irudoy/openmfd/firmware/TouchGFX/assets/images/graph-bg-6-11.png

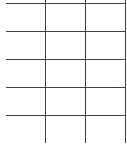
firmware/TouchGFX/assets/images/graph-bg-6-11.png
