irudoy/openmfd/hardware/dev-board/dev-board.kicad_pcb

## KiCad design hardware/dev-board/dev-board.kicad_pcb (2024-07-24)

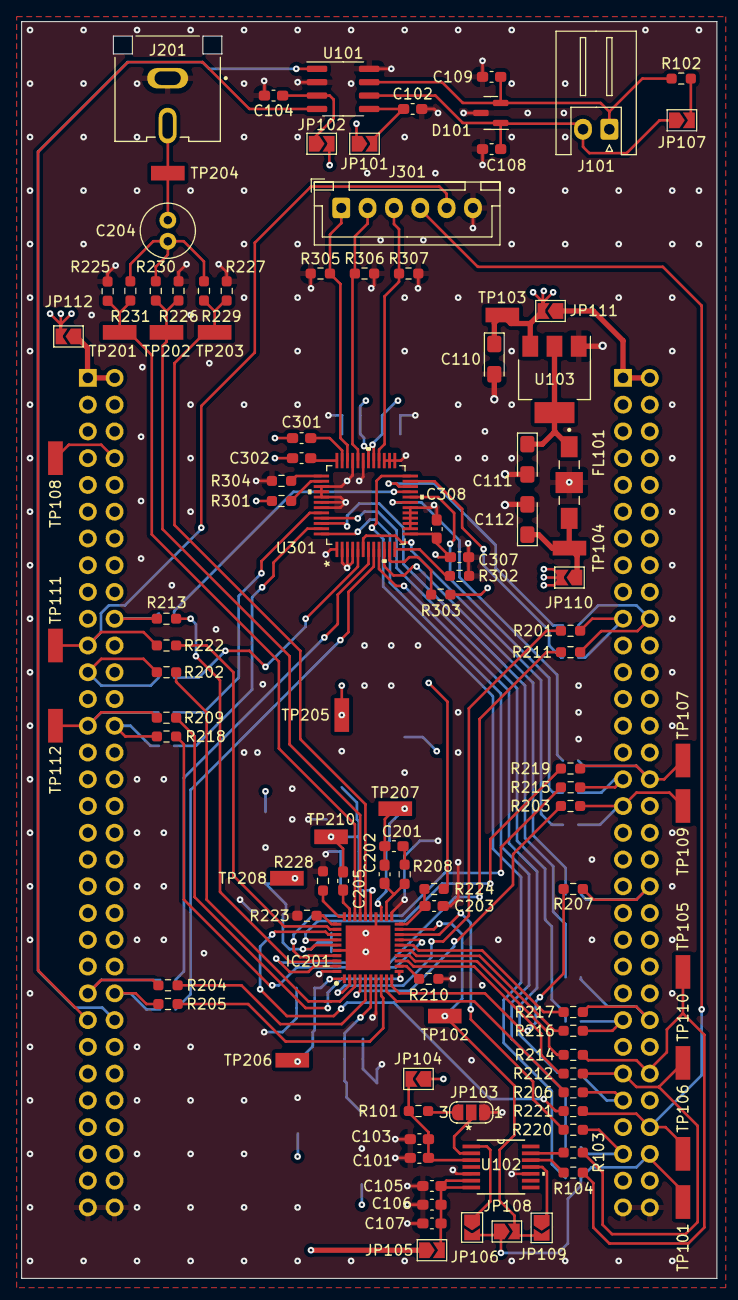
[picture p2: board dev-board.kicad_pcb from above]

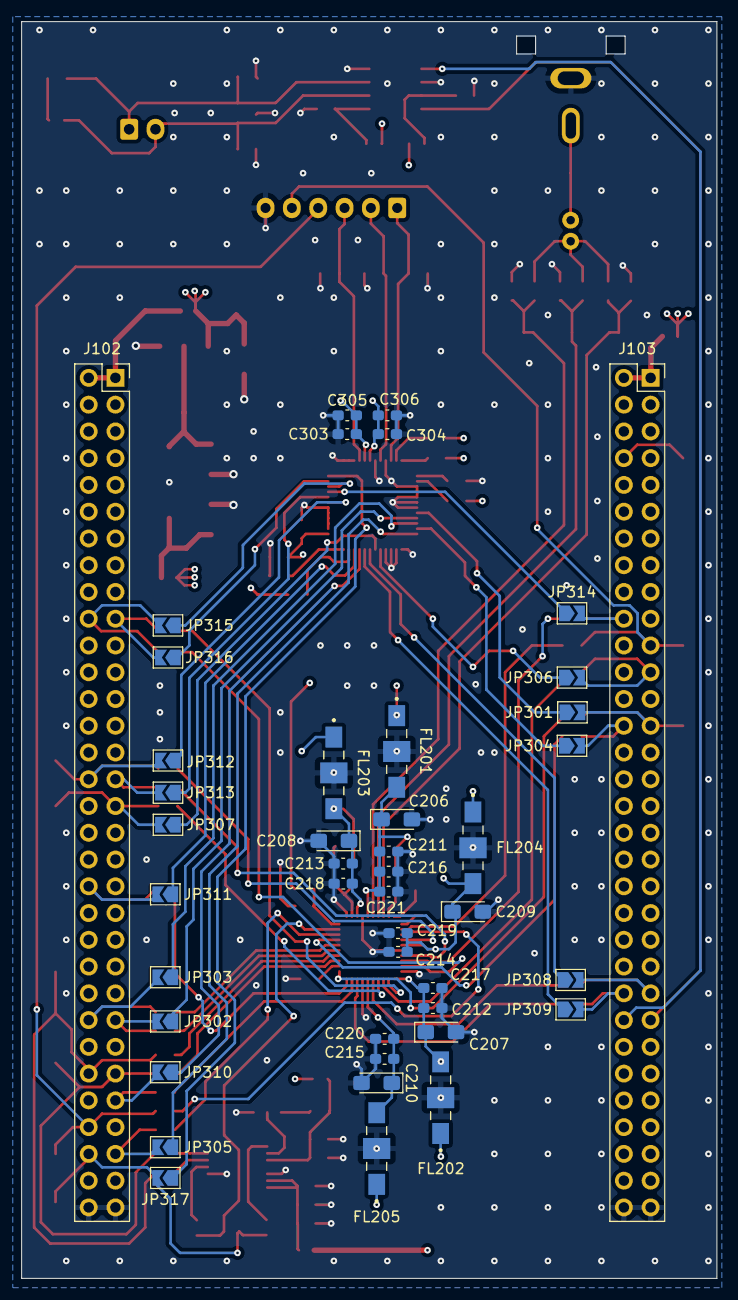
[picture p3: board dev-board.kicad_pcb from below]

Board: 4 copper layers, 66.0 x 119.3 mm, 150 parts (44 on the bottom side), 109 nets.

Parts:
C101, C102, C104, C105, C106, C203, C211, C212, C213, C214, C215: 100n; C_0603_1608Metric_Pad1.08x0.95mm_HandSolder
C103, C107, C221: 1u; C_0603_1608Metric_Pad1.08x0.95mm_HandSolder
C108, C109: 47p; C_0603_1608Metric_Pad1.08x0.95mm_HandSolder
C110: 10u; CP_EIA-3216-18_Kemet-A_Pad1.58x1.35mm_HandSolder
C111: 22u; CP_EIA-3216-18_Kemet-A_Pad1.58x1.35mm_HandSolder
C112, C206, C207, C208, C209, C210: 33u; CP_EIA-3216-18_Kemet-A_Pad1.58x1.35mm_HandSolder
C201: 150n; C_0603_1608Metric_Pad1.08x0.95mm_HandSolder
C202: 12n; C_0603_1608Metric_Pad1.08x0.95mm_HandSolder
C204: 220uf; C_Radial_D5.0mm_H11.0mm_P2.00mm
C205: 2n2; C_0603_1608Metric_Pad1.08x0.95mm_HandSolder
C216, C217, C218, C219, C220: 10n; C_0603_1608Metric_Pad1.08x0.95mm_HandSolder
C301, C302, C303, C304, C307: 100nf; C_0603_1608Metric_Pad1.08x0.95mm_HandSolder
C305, C306, C308: 10nf; C_0603_1608Metric_Pad1.08x0.95mm_HandSolder
D101: ESDCAN24-2BLY; SOT-23
FL101, FL201, FL202, FL203, FL204, FL205: Filter_EMI_LCL; FIL_NFE61PT472C1H9L
IC201: ADV7393BCPZ; QFN50P600X600X80-41N
J101: Conn_01x02_Pin; JST_XH_S2B-XH-A_1x02_P2.50mm_Horizontal
J102: DISC1-P1; PinSocket_2x32_P2.54mm_Vertical
J103: DISC1-P2; PinSocket_2x32_P2.54mm_Vertical
J201: CVBS; CUI_RCJ-044
J301: Connector RGB; JST_XH_B6B-XH-A_1x06_P2.50mm_Vertical
JP101, JP102, JP104, JP105, JP106, JP107, JP108, JP109, JP110, JP111, JP112, JP301, JP302, JP303, JP304, JP305, JP306, JP307, JP308, JP309, JP310, JP311, JP312, JP313, JP314, JP315, JP316, JP317: SolderJumper_2_Open; SolderJumper-2_P1.3mm_Open_TrianglePad1.0x1.5mm
JP103: SolderJumper_3_Open; SolderJumper-3_P1.3mm_Open_RoundedPad1.0x1.5mm_NumberLabels
R101, R223, R229, R230, R231: 0Ω; R_0603_1608Metric_Pad0.98x0.95mm_HandSolder
R102: 120; R_0603_1608Metric_Pad0.98x0.95mm_HandSolder
R103, R104, R201, R202, R203, R204, R205, R206, R207, R209, R210, R211, R212, R213, R214, R215, R216, R217, R218, R219, R220, R221, R222: 0; R_0603_1608Metric_Pad0.98x0.95mm_HandSolder
R208: 170 (169); R_0603_1608Metric_Pad0.98x0.95mm_HandSolder
R224: 10K; R_0603_1608Metric_Pad0.98x0.95mm_HandSolder
R225, R226, R227, R305, R306, R307: 75; R_0603_1608Metric_Pad0.98x0.95mm_HandSolder
R228: 510 1%; R_0603_1608Metric_Pad0.98x0.95mm_HandSolder
R301, R303: 4K7; R_0603_1608Metric_Pad0.98x0.95mm_HandSolder
R302: 1K; R_0603_1608Metric_Pad0.98x0.95mm_HandSolder
R304: 560; R_0603_1608Metric_Pad0.98x0.95mm_HandSolder
TP101, TP102, TP103, TP104, TP105, TP106, TP107, TP108, TP109, TP110, TP111, TP112, TP201, TP202, TP203, TP204, TP205, TP206, TP207, TP208, TP210: TestPoint_Flag; KEYSTONE_5015
U101: MCP2562-E-SN; SOIC-8_3.9x4.9mm_P1.27mm
U102: CDCE913PW; PW14
U103: AMS1117-1.8; SOT-223-3_TabPin2
U301: ADV7125KSTZ140

Connections:
+1V8: FL203.1, FL204.1, FL205.1, JP104.1 (A), JP110.2 (B)
+1V8_I: C101.1, C103.1, JP104.2 (B), R101.1, U102.3 (VDD)
+3V3: FL201.1, FL202.1, JP101.1 (A), JP105.1 (A), JP112.2 (B), R224.2, TP205.1
+3V3_C: C102.1, JP101.2 (B), U101.5 (Vio)
+3V3_I: C105.1, C106.1, C107.1, JP105.2 (B), U102.6 (VDDOUT), U102.7 (VDDOUT)
+3V3_IN: J103.1 (3V3), J103.2 (3V3), JP112.1 (A)
+5V: C110.1, C301.2, C302.2, C303.2, C304.2, C305.2, C306.2, C307.2, C308.2, JP102.2 (B), JP111.2 (B), R301.2, R303.2, TP103.1, U103.3 (VI), U301.13 (VAA), U301.29 (VAA), U301.30 (VAA)
+5V_C: C104.1, JP102.1 (A), U101.3 (VDD)
+5V_IN: J102.1 (5V), J102.2 (5V), JP111.1 (A)
/CANH: C109.1, D101.2 (K), J101.1, R102.1, U101.7 (CANH)
/CANL: C108.2, D101.1 (K), J101.2, JP107.1 (A), U101.6 (CANL)
ADV7_B3: JP312.1 (A), U301.19 (B3)
ADV7_B4: JP313.1 (A), U301.20 (B4)
ADV7_B5: JP314.1 (A), U301.21 (B5)
ADV7_B6: JP315.1 (A), U301.22 (B6)
ADV7_B7: JP316.1 (A), U301.23 (B7)
ADV7_CLK: JP317.1 (A), U301.24 (CLOCK)
ADV7_G2: JP306.1 (A), U301.5 (G2)
ADV7_G3: JP307.1 (A), U301.6 (G3)
ADV7_G4: JP308.1 (A), U301.7 (G4)
ADV7_G5: JP309.1 (A), U301.8 (G5)
ADV7_G6: JP310.1 (A), U301.9 (G6)
ADV7_G7: JP311.1 (A), U301.10 (G7)
ADV7_IOB: J301.3, R307.1, U301.28 (IOB)
ADV7_IOG: J301.2, R306.1, U301.32 (IOG)
ADV7_IOR: J301.1, R305.1, U301.34 (IOR)
ADV7_R3: JP301.1 (A), U301.44 (R3)
ADV7_R4: JP302.1 (A), U301.45 (R4)
ADV7_R5: JP303.1 (A), U301.46 (R5)
ADV7_R6: JP304.1 (A), U301.47 (R6)
ADV7_R7: JP305.1 (A), U301.48 (R7)
ADV_CLKIN: IC201.19 (CLKIN), JP108.2 (B), JP109.2 (B), TP102.1
ADV_COMP: C205.2, IC201.29 (COMP)
ADV_RSET: IC201.30 (RSET), R228.2
AVDD_3V3: C205.1, C206.1, C211.1, C216.1, C221.1, FL201.3, IC201.25 (VAA), TP210.1
CAN_RX: J103.49 (PB12), U101.4 (RXD)
CAN_TX: J103.50 (PB13), U101.1 (TXD)
DAC_1: IC201.28 (DAC_1), R225.2, R231.2, TP201.1
DAC_2: IC201.27 (DAC_2), R226.2, R230.2, TP202.1
DAC_3: IC201.26 (DAC_3), R227.2, R229.2, TP203.1
DVDD_1V8_1: C210.1, C215.1, C220.1, FL205.3, IC201.6 (VDD_1)
DVDD_1V8_2: C209.1, C214.1, C219.1, FL204.3, IC201.35 (VDD_2), TP208.1
DVDD_IO_3V3: C207.1, C212.1, C217.1, FL202.3, IC201.1 (VDD_IO), TP206.1
EXT_LF: C202.2, IC201.22 (EXT_LF), R208.1
GND: C101.2, C102.2, C103.2, C104.2, C105.2, C106.2, C107.2, C108.1, C109.2, C110.2, C111.2, C112.2, C203.2, C206.2, C207.2, C208.2, C209.2, C210.2, C211.2, C212.2, C213.2, C214.2, C215.2, C216.2, C217.2, C218.2, C219.2, C220.2, C221.2, C303.1, C304.1, C305.1, C306.1, C307.1, C308.1, D101.3 (A), FL101.2, FL201.2, FL202.2, FL203.2, FL204.2, FL205.2, IC201.7 (DGND_1), IC201.21 (PGND), IC201.24 (AGND_1), IC201.36 (DGND_2), IC201.40 (GND_IO), IC201.41 (AGND_2), J102.63 (GND), J102.64 (GND), J103.63 (GND), J103.64 (GND), J201.2 (Ext), J301.6, JP103.1 (A), R210.1, R223.1, R225.1, R226.1, R227.1, R228.1, R302.2, R304.2, R305.2, R306.2, R307.2, U101.2 (VSS), U101.8 (STBY), U102.5 (GND), U102.10 (GND), U103.1 (GND), U301.1 (GND), U301.2 (GND), U301.3 (G0), U301.4 (G1), U301.14 (GND), U301.15 (GND), U301.16 (B0), U301.17 (B1), U301.18 (B2), U301.25 (GND), U301.26 (GND), U301.27 (IOB*), U301.31 (IOG*), U301.33 (IOR*), U301.39 (GND), U301.40 (GND), U301.41 (R0), U301.42 (R1), U301.43 (R2)
I2C_SCL: J102.54 (PA8), R104.1, R214.1, TP105.1
I2C_SDA: J102.53 (PC9), R103.1, R212.1, TP110.1
LTDC_B3: J102.32 (PG11), JP312.2 (B), R219.2, TP107.1
LTDC_B4: J102.31 (PG12), JP313.2 (B), R215.2
LTDC_B5: J103.20 (PA3), JP314.2 (B), R213.2
LTDC_B6: J102.20 (PB8), JP315.2 (B), R211.2
LTDC_B7: J102.19 (PB9), JP316.2 (B), R201.1
LTDC_CLK: J102.60 (PG7), JP106.2 (B), JP108.1 (A), JP317.2 (B), TP101.1
LTDC_DE: J103.8 (PF10), TP108.1
LTDC_G2: J103.23 (PA6), JP306.2 (B), R202.1
LTDC_G3: J102.33 (PG10), JP307.2 (B), R203.1, TP109.1
LTDC_G4: J103.47 (PB10), JP308.2 (B), R204.1
LTDC_G5: J103.48 (PB11), JP309.2 (B), R205.1
LTDC_G6: J102.55 (PC7), JP310.2 (B), R206.1
LTDC_G7: J102.40 (PD3), JP311.2 (B), R207.1
LTDC_HSYNC: J102.58 (PC6), J301.4, R221.2, TP106.1
LTDC_R3: J103.27 (PB0), JP301.2 (B), R209.1, TP112.1
LTDC_R4: J102.49 (PA11), JP302.2 (B), R216.1
LTDC_R5: J102.50 (PA12), JP303.2 (B), R217.1
LTDC_R6: J103.28 (PB1), JP304.2 (B), R218.1
LTDC_R7: J102.59 (PG6), JP305.2 (B), R220.1
LTDC_VSYNC: J103.21 (PA4), J301.5, R222.2, TP111.1
unnamed: C201.2, R208.2
unnamed: C204.1, R229.1, R230.1, R231.1
unnamed: IC201.12 (ALSB), R210.2
unnamed: IC201.34 (P0), R219.1
unnamed: IC201.37 (P1), R215.1
unnamed: IC201.38 (P2), R213.1
unnamed: IC201.39 (P3), R211.1
unnamed: IC201.2 (P4), R201.2
unnamed: IC201.3 (P5), R202.2
unnamed: IC201.4 (P6), R203.2
unnamed: IC201.5 (P7), R204.2
unnamed: IC201.8, R205.2
unnamed: IC201.9, R206.2
unnamed: IC201.10, R207.2
unnamed: IC201.11, R209.2
unnamed: IC201.15 (P12), R216.2
unnamed: IC201.16 (P13), R217.2
unnamed: IC201.17 (P14), R218.2
unnamed: IC201.18 (P15), R220.2
unnamed: IC201.14 (SCL), R214.2
unnamed: IC201.13 (SDA), R212.2
unnamed: IC201.33 (~HSYNC), R221.1
unnamed: C203.1, IC201.20 (~RESET), R224.1
unnamed: IC201.32 (~VSYNC), R222.1
unnamed: C204.2, J201.1 (In), TP204.1
unnamed: JP103.3 (B), R101.2
unnamed: JP103.2 (C), U102.2 (S0)
unnamed: JP106.1 (A), U102.1 (XIN/CLK)
unnamed: JP107.2 (B), R102.2
unnamed: JP109.1 (A), U102.11 (Y1)
unnamed: C112.1, FL101.3, JP110.1 (A), TP104.1
unnamed: R103.2, U102.13 (S1/SDA)
unnamed: R104.2, U102.12 (S2/SCL)
unnamed: C111.1, FL101.1, U103.2 (VO)
unnamed: R303.1, U301.11 (BLANK*)
unnamed: C301.1, U301.35 (COMP)
unnamed: R301.1, U301.38 (PSAVE*)
unnamed: R304.1, U301.37 (RSET)
unnamed: R302.1, U301.12 (SYNC*)
unnamed: C302.1, U301.36 (VREF)
PVDD_1V8: C201.1, C202.1, C208.1, C213.1, C218.1, FL203.3, IC201.23 (PVDD), TP207.1
SFL: IC201.31 (SFL), R223.2
