irudoy/openmfd/hardware/openmfd/dummy/openmfd.kicad_pcb

## KiCad design hardware/openmfd/dummy/openmfd.kicad_pcb (2024-05-24)

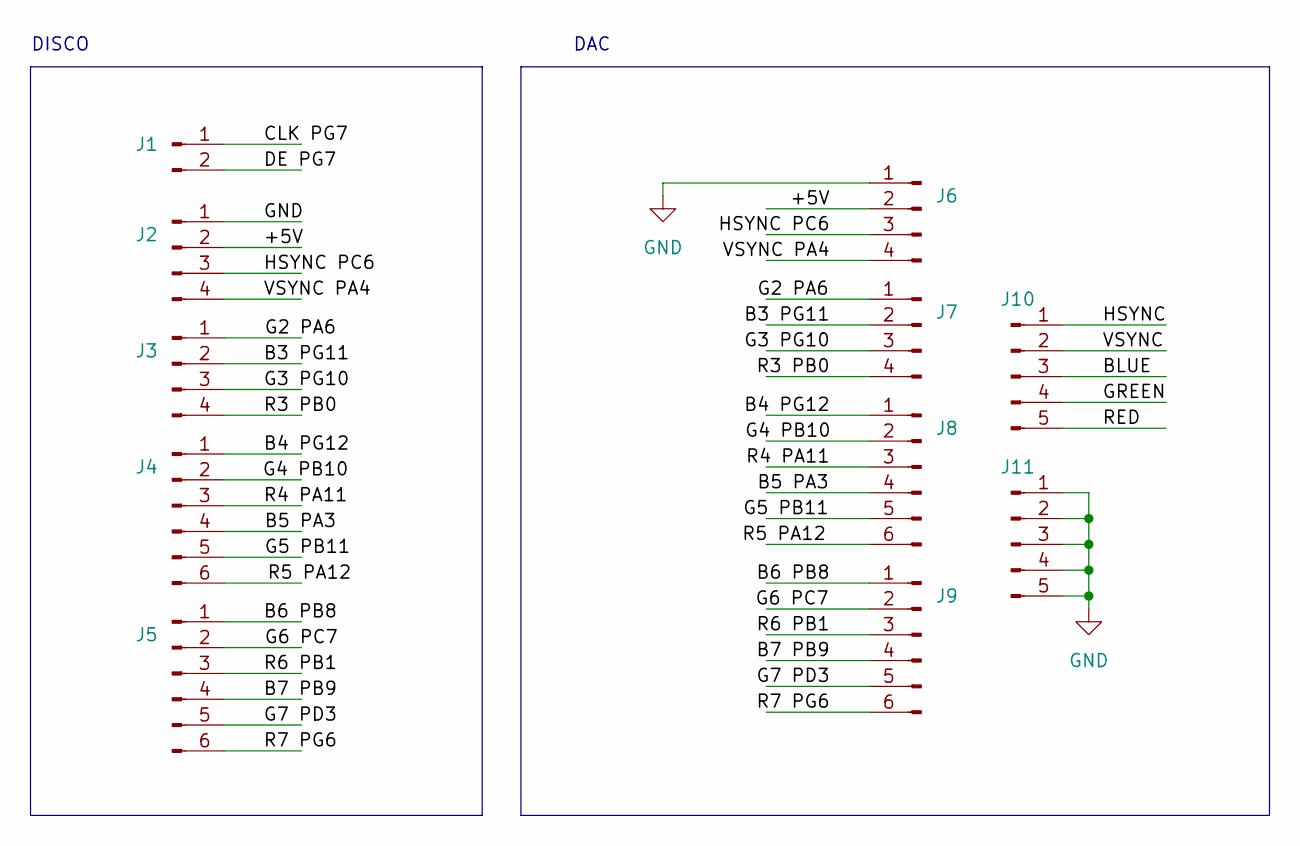
[picture p4: schematic openmfd.kicad_sch]

Parts:
J1: Conn_01x02_Male; JST_XH_B2B-XH-A_1x02_P2.50mm_Vertical
J2, J3, J6, J7: Conn_01x04_Male; JST_XH_B4B-XH-A_1x04_P2.50mm_Vertical
J4, J5, J8, J9: Conn_01x06_Male; JST_XH_B6B-XH-A_1x06_P2.50mm_Vertical
J10, J11: Conn_01x05_Male; JST_XH_B5B-XH-A_1x05_P2.50mm_Vertical

Connections:
/+5V: J2.2, J6.2
/B3 PG11: J3.2, J7.2
/B4 PG12: J4.1, J8.1
/B5 PA3: J4.4, J8.4
/B6 PB8: J5.1, J9.1
/B7 PB9: J5.4, J9.4
/BLUE: J10.3
/CLK PG7: J1.1
/DE PG7: J1.2
/G2 PA6: J3.1, J7.1
/G3 PG10: J3.3, J7.3
/G4 PB10: J4.2, J8.2
/G5 PB11: J4.5, J8.5
/G6 PC7: J5.2, J9.2
/G7 PD3: J5.5, J9.5
/GREEN: J10.4
/HSYNC: J10.1
/HSYNC PC6: J2.3, J6.3
/R3 PB0: J3.4, J7.4
/R4 PA11: J4.3, J8.3
/R5 PA12: J4.6, J8.6
/R6 PB1: J5.3, J9.3
/R7 PG6: J5.6, J9.6
/RED: J10.5
/VSYNC: J10.2
/VSYNC PA4: J2.4, J6.4
GND: J2.1, J6.1, J11.1, J11.2, J11.3, J11.4, J11.5

Notes on the sheet:
DAC
DISCO

Board: 2 copper layers, 11 parts (0 on the bottom side), 20 nets, no tracks yet.
