irudoy/openmfd/hardware/rgb-composite/rgb-composite.kicad_pcb

## KiCad design hardware/rgb-composite/rgb-composite.kicad_pcb (2024-05-24)

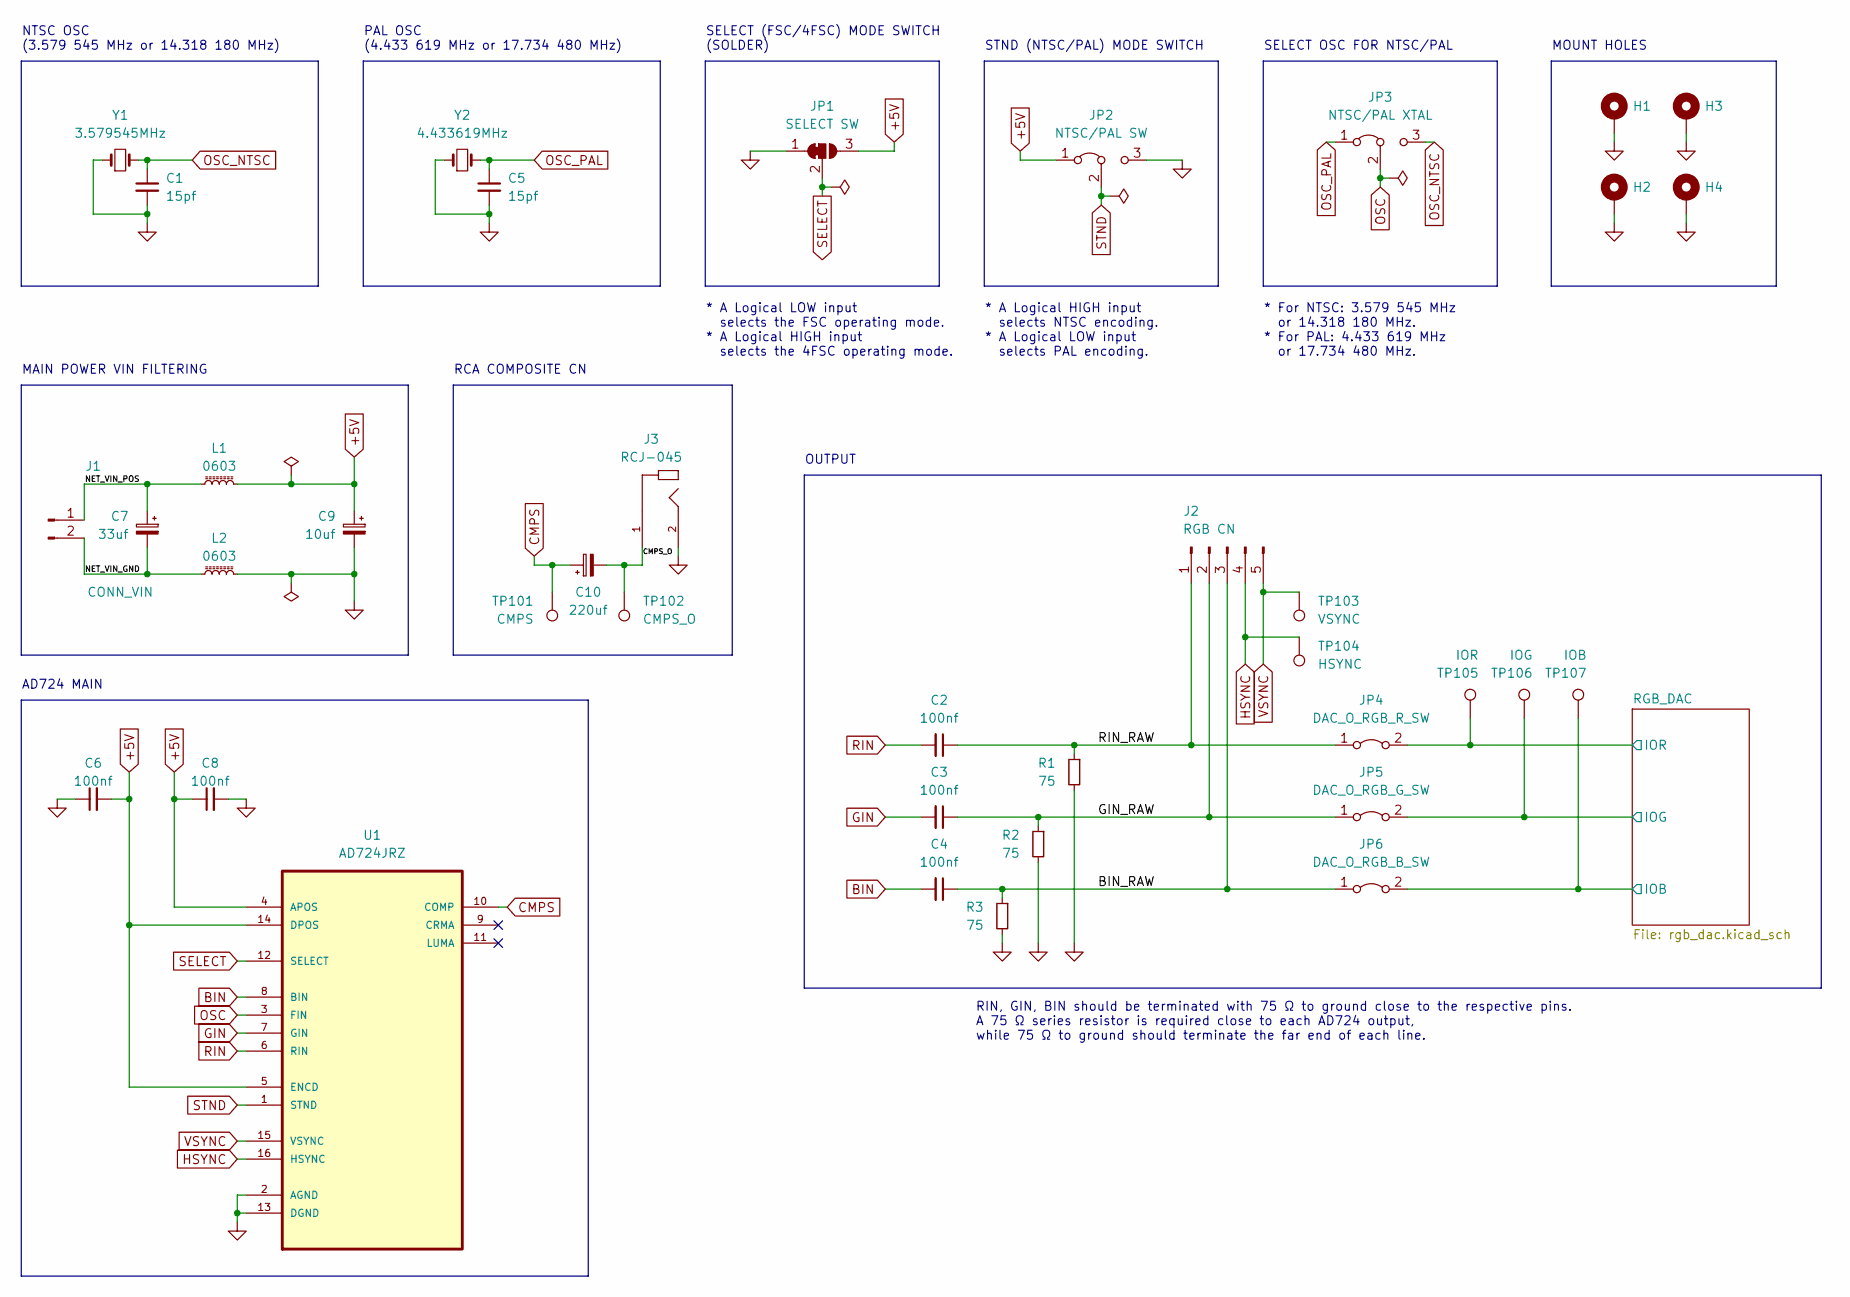
[picture p5: schematic rgb-composite.kicad_sch]

Parts:
C1, C5: 15pf; C_0603_1608Metric_Pad1.08x0.95mm_HandSolder
C2, C3, C4, C6, C8: 100nf; C_0603_1608Metric_Pad1.08x0.95mm_HandSolder
C7: 33uf; CP_EIA-3528-21_Kemet-B_Pad1.50x2.35mm_HandSolder
C9: 10uf; CP_EIA-3216-18_Kemet-A_Pad1.58x1.35mm_HandSolder
C10: 220uf; C_Radial_D5.0mm_H11.0mm_P2.00mm
H1, H2, H3, H4: MountingHole_Pad; MountingHole_3.2mm_M3_Pad_Via
J1: CONN_VIN; JST_XH_B2B-XH-A_1x02_P2.50mm_Vertical
J2: RGB CN; JST_XH_B5B-XH-A_1x05_P2.50mm_Vertical
J3: RCJ-045; CUI_RCJ-JP
JP1: SELECT SW; SolderJumper-3_P1.3mm_Open_RoundedPad1.0x1.5mm
JP2: NTSC/PAL SW; PinHeader_1x03_P2.54mm_Vertical
JP3: NTSC/PAL XTAL; PinHeader_1x03_P2.54mm_Vertical
JP4: DAC_O_RGB_R_SW; PinHeader_1x02_P2.54mm_Vertical
JP5: DAC_O_RGB_G_SW; PinHeader_1x02_P2.54mm_Vertical
JP6: DAC_O_RGB_B_SW; PinHeader_1x02_P2.54mm_Vertical
L1, L2: 0603; L_0603_1608Metric_Pad1.05x0.95mm_HandSolder
R1, R2, R3: 75; R_0603_1608Metric_Pad0.98x0.95mm_HandSolder
TP101: CMPS; TestPoint_Loop_D2.60mm_Drill0.9mm_Beaded
TP102: CMPS_O; TestPoint_Loop_D2.60mm_Drill0.9mm_Beaded
TP103: VSYNC; TestPoint_Loop_D2.60mm_Drill0.9mm_Beaded
TP104: HSYNC; TestPoint_Loop_D2.60mm_Drill0.9mm_Beaded
TP105: IOR; TestPoint_Loop_D2.60mm_Drill0.9mm_Beaded
TP106: IOG; TestPoint_Loop_D2.60mm_Drill0.9mm_Beaded
TP107: IOB; TestPoint_Loop_D2.60mm_Drill0.9mm_Beaded
U1: AD724JRZ; SOIC127P1032X265-16N; MPN AD724JRZ
Y1: 3.579545MHz; Crystal_HC49-4H_Vertical
Y2: 4.433619MHz; Crystal_HC49-U_Vertical

Connections:
+5V: C6.2, C8.1, C9.1, JP1.3 (B), JP2.1 (A), L1.1, U1.4 (APOS), U1.5 (ENCD), U1.14 (DPOS); also elsewhere on the board
/BIN_RAW: C4.1, J2.3, JP6.1 (A), R3.1
/CMPS_O: C10.2, J3.1, TP102.1
/GIN_RAW: C3.1, J2.2, JP5.1 (A), R2.1
/NET_VIN_GND: C7.2, J1.2, L2.2
/NET_VIN_POS: C7.1, J1.1, L1.2
/RIN_RAW: C2.1, J2.1, JP4.1 (A), R1.1
BIN: C4.2, U1.8 (BIN)
CMPS: C10.1, TP101.1, U1.10 (COMP)
GIN: C3.2, U1.7 (GIN)
GND: C1.2, C5.2, C6.1, C8.2, C9.2, H1.1, H2.1, H3.1, H4.1, J3.2, JP1.1 (A), JP2.3 (B), L2.1, R1.2, R2.2, R3.2, U1.2 (AGND), U1.13 (DGND), Y1.1, Y2.1; also elsewhere on the board
HSYNC: J2.4, TP104.1, U1.16 (HSYNC)
IOB: JP6.2 (B), TP107.1; also elsewhere on the board
IOG: JP5.2 (B), TP106.1; also elsewhere on the board
IOR: JP4.2 (B), TP105.1; also elsewhere on the board
OSC: JP3.2 (C), U1.3 (FIN)
OSC_NTSC: C1.1, JP3.3 (B), Y1.2
OSC_PAL: C5.1, JP3.1 (A), Y2.2
RIN: C2.2, U1.6 (RIN)
SELECT: JP1.2 (C), U1.12 (SELECT)
STND: JP2.2 (C), U1.1 (STND)
VSYNC: J2.5, TP103.1, U1.15 (VSYNC)

Notes on the sheet:
OUTPUT
* For NTSC: 3.579 545 MHz or 14.318 180 MHz. * For PAL: 4.433 619 MHz or 17.734 480 MHz.
SELECT (FSC/4FSC) MODE SWITCH (SOLDER)
AD724 MAIN
* A Logical HIGH input selects NTSC encoding. * A Logical LOW input selects PAL encoding.
RCA COMPOSITE CN
SELECT OSC FOR NTSC/PAL
NTSC OSC (3.579 545 MHz or 14.318 180 MHz)
MOUNT HOLES
PAL OSC (4.433 619 MHz or 17.734 480 MHz)
* A Logical LOW input selects the FSC operating mode. * A Logical HIGH input selects the 4FSC operating mode.
RIN, GIN, BIN should be terminated with 75 Ω to ground close to the respective pins. A 75 Ω series resistor is required close to each AD724 output, while 75 Ω to ground should terminate the far end of each line.
MAIN POWER VIN FILTERING
STND (NTSC/PAL) MODE SWITCH

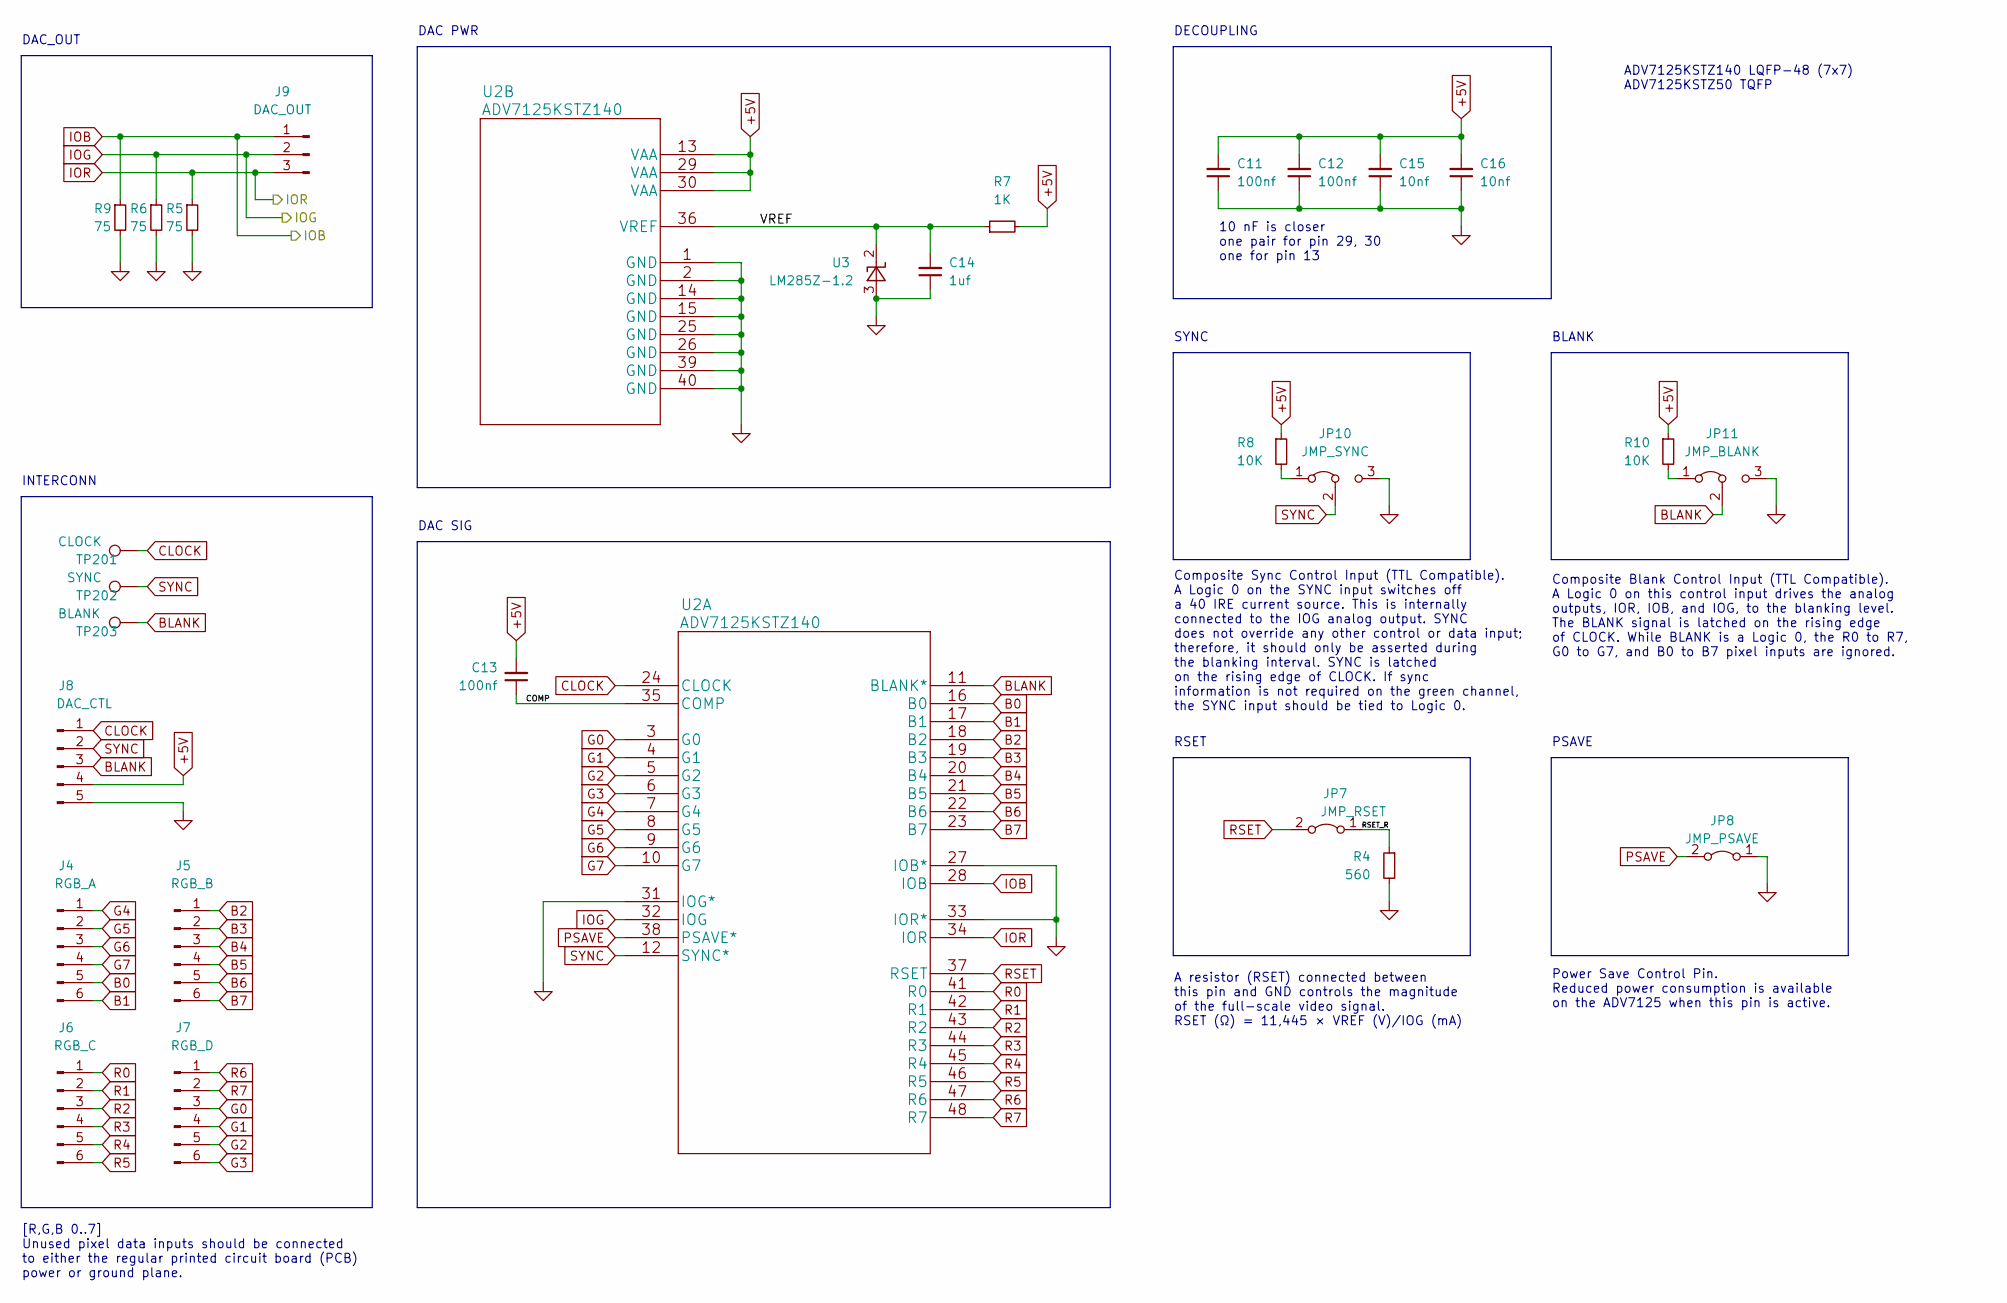
[picture p6: schematic rgb_dac.kicad_sch]

Parts:
C11, C12, C13: 100nf; C_0603_1608Metric_Pad1.08x0.95mm_HandSolder
C14: 1uf; C_0603_1608Metric_Pad1.08x0.95mm_HandSolder
C15, C16: 10nf; C_0603_1608Metric_Pad1.08x0.95mm_HandSolder
J4: RGB_A; JST_XH_B6B-XH-A_1x06_P2.50mm_Vertical
J5: RGB_B; JST_XH_B6B-XH-A_1x06_P2.50mm_Vertical
J6: RGB_C; JST_XH_B6B-XH-A_1x06_P2.50mm_Vertical
J7: RGB_D; JST_XH_B6B-XH-A_1x06_P2.50mm_Vertical
J8: DAC_CTL; JST_XH_B5B-XH-A_1x05_P2.50mm_Vertical
J9: DAC_OUT; JST_XH_B3B-XH-A_1x03_P2.50mm_Vertical
JP7: JMP_RSET; PinHeader_1x02_P2.54mm_Vertical
JP8: JMP_PSAVE; PinHeader_1x02_P2.54mm_Vertical
JP10: JMP_SYNC; PinHeader_1x03_P2.54mm_Vertical
JP11: JMP_BLANK; PinHeader_1x03_P2.54mm_Vertical
R4: 560; R_0603_1608Metric_Pad0.98x0.95mm_HandSolder
R5, R6, R9: 75; R_0603_1608Metric_Pad0.98x0.95mm_HandSolder
R7: 1K; R_0603_1608Metric_Pad0.98x0.95mm_HandSolder
R8, R10: 10K; R_0603_1608Metric_Pad0.98x0.95mm_HandSolder
TP201: CLOCK; TestPoint_Loop_D2.60mm_Drill0.9mm_Beaded
TP202: SYNC; TestPoint_Loop_D2.60mm_Drill0.9mm_Beaded
TP203: BLANK; TestPoint_Loop_D2.60mm_Drill0.9mm_Beaded
U2: ADV7125KSTZ140
U3: LM285Z-1.2; TO-92_Inline

Connections:
+5V: C11.2, C12.2, C13.2, C15.2, C16.2, J8.4, R7.2, R8.1, R10.1, U2.13 (VAA), U2.29 (VAA), U2.30 (VAA); also elsewhere on the board
/RGB_DAC/COMP: C13.1, U2.35 (COMP)
/RGB_DAC/RSET_R: JP7.1 (A), R4.1
/RGB_DAC/VREF: C14.2, R7.1, U2.36 (VREF), U3.2 (K); also elsewhere on the board
B0: J4.5, U2.16 (B0)
B1: J4.6, U2.17 (B1)
B2: J5.1, U2.18 (B2)
B3: J5.2, U2.19 (B3)
B4: J5.3, U2.20 (B4)
B5: J5.4, U2.21 (B5)
B6: J5.5, U2.22 (B6)
B7: J5.6, U2.23 (B7)
BLANK: J8.3, JP11.2 (C), TP203.1, U2.11 (BLANK*)
CLOCK: J8.1, TP201.1, U2.24 (CLOCK)
G0: J7.3, U2.3 (G0)
G1: J7.4, U2.4 (G1)
G2: J7.5, U2.5 (G2)
G3: J7.6, U2.6 (G3)
G4: J4.1, U2.7 (G4)
G5: J4.2, U2.8 (G5)
G6: J4.3, U2.9 (G6)
G7: J4.4, U2.10 (G7)
GND: C11.1, C12.1, C14.1, C15.1, C16.1, J8.5, JP8.1 (A), JP10.3 (B), JP11.3 (B), R4.2, R5.2, R6.2, R9.2, U2.1 (GND), U2.2 (GND), U2.14 (GND), U2.15 (GND), U2.25 (GND), U2.26 (GND), U2.27 (IOB*), U2.31 (IOG*), U2.33 (IOR*), U2.39 (GND), U2.40 (GND), U3.3 (A); also elsewhere on the board
IOB: J9.1, R9.1, U2.28 (IOB); also elsewhere on the board
IOG: J9.2, R6.1, U2.32 (IOG); also elsewhere on the board
IOR: J9.3, R5.1, U2.34 (IOR); also elsewhere on the board
unnamed: JP10.1 (A), R8.2
unnamed: JP11.1 (A), R10.2
PSAVE: JP8.2 (B), U2.38 (PSAVE*)
R0: J6.1, U2.41 (R0)
R1: J6.2, U2.42 (R1)
R2: J6.3, U2.43 (R2)
R3: J6.4, U2.44 (R3)
R4: J6.5, U2.45 (R4)
R5: J6.6, U2.46 (R5)
R6: J7.1, U2.47 (R6)
R7: J7.2, U2.48 (R7)
RSET: JP7.2 (B), U2.37 (RSET)
SYNC: J8.2, JP10.2 (C), TP202.1, U2.12 (SYNC*)

Notes on the sheet:
10 nF is closer one pair for pin 29, 30 one for pin 13
DECOUPLING
[R,G,B 0..7] Unused pixel data inputs should be connected to either the regular printed circuit board (PCB) power or ground plane.
RSET
DAC PWR
SYNC
DAC SIG
BLANK
PSAVE
INTERCONN
DAC_OUT
Composite Blank Control Input (TTL Compatible). A Logic 0 on this control input drives the analog outputs, IOR, IOB, and IOG, to the blanking level. The BLANK signal is latched on the rising edge of CLOCK. While BLANK is a Logic 0, the R0 to R7, G0 to G7, and B0 to B7 pixel inputs are ignored.
Power Save Control Pin. Reduced power consumption is available on the ADV7125 when this pin is active.
Composite Sync Control Input (TTL Compatible). A Logic 0 on the SYNC input switches off a 40 IRE current source. This is internally connected to the IOG analog output. SYNC does not override any other control or data input; therefore, it should only be asserted during the blanking interval. SYNC is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
A resistor (RSET) connected between this pin and GND controls the magnitude of the full-scale video signal. RSET (Ω) = 11,445 × VREF (V)/IOG (mA)
ADV7125KSTZ140 LQFP-48 (7x7) ADV7125KSTZ50 TQFP

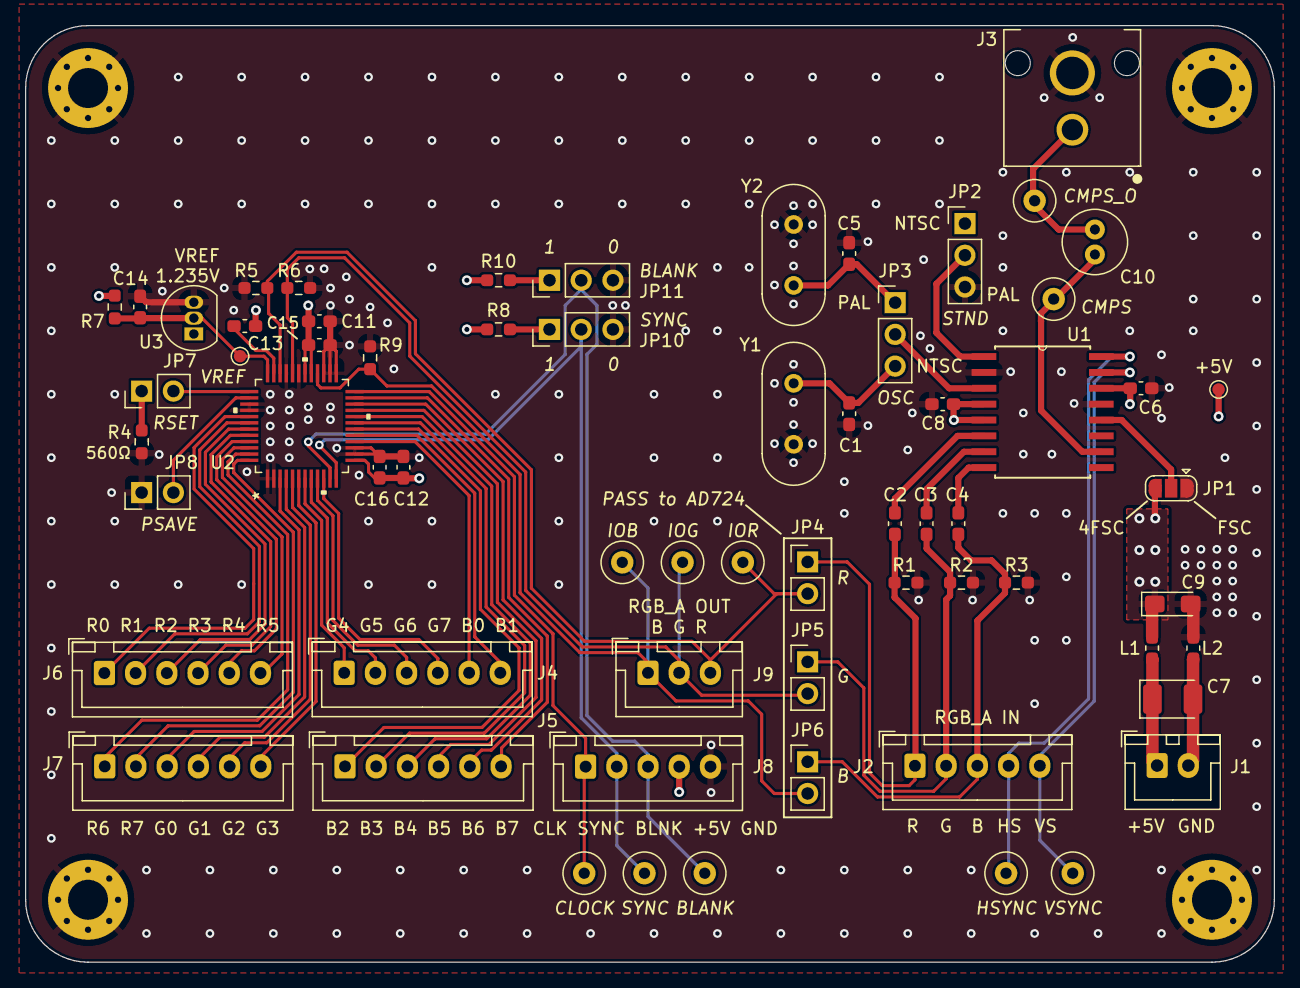
[picture p7: board rgb-composite.kicad_pcb from above]

Board: 4 copper layers, 100.0 x 75.0 mm, 67 parts (0 on the bottom side), 56 nets.

Other parts of the board:
VREF: TestPoint_Pad_D1.0mm

Their connections:
/RGB_DAC/VREF: VREF.1; also elsewhere on the board
