irudoy/openmfd/firmware/Core/Src/main.c

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
/* Includes ------------------------------------------------------------------*/
#include "main.h"
#include "cmsis_os.h"
#include "app_touchgfx.h"

/* USER CODE BEGIN Includes */
#include "stdbool.h"
#include "comm.h"
#include "ili9341/ili9341.h"
#include "data.h"
#include "debug_screen.h"
#include "debug_data.h"
/* USER CODE END Includes */

/* USER CODE BEGIN PD */
#define REFRESH_COUNT           ((uint32_t)1386)   /* SDRAM refresh counter */
#define SDRAM_TIMEOUT           ((uint32_t)0xFFFF)

/**
  * @brief  FMC SDRAM Mode definition register defines
  */
#define SDRAM_MODEREG_BURST_LENGTH_1             ((uint16_t)0x0000)
#define SDRAM_MODEREG_BURST_LENGTH_2             ((uint16_t)0x0001)
#define SDRAM_MODEREG_BURST_LENGTH_4             ((uint16_t)0x0002)
#define SDRAM_MODEREG_BURST_LENGTH_8             ((uint16_t)0x0004)
#define SDRAM_MODEREG_BURST_TYPE_SEQUENTIAL      ((uint16_t)0x0000)
#define SDRAM_MODEREG_BURST_TYPE_INTERLEAVED     ((uint16_t)0x0008)
#define SDRAM_MODEREG_CAS_LATENCY_2              ((uint16_t)0x0020)
#define SDRAM_MODEREG_CAS_LATENCY_3              ((uint16_t)0x0030)
#define SDRAM_MODEREG_OPERATING_MODE_STANDARD    ((uint16_t)0x0000)
#define SDRAM_MODEREG_WRITEBURST_MODE_PROGRAMMED ((uint16_t)0x0000)
#define SDRAM_MODEREG_WRITEBURST_MODE_SINGLE     ((uint16_t)0x0200)

#define I2C3_TIMEOUT_MAX                    0x3000 /*<! The value of the maximal timeout for I2C waiting loops */
#define SPI5_TIMEOUT_MAX                    0x1000
/* USER CODE END PD */

CAN_HandleTypeDef hcan2;

CRC_HandleTypeDef hcrc;

DMA2D_HandleTypeDef hdma2d;

I2C_HandleTypeDef hi2c3;

LTDC_HandleTypeDef hltdc;

RNG_HandleTypeDef hrng;

SPI_HandleTypeDef hspi5;

TIM_HandleTypeDef htim1;

SDRAM_HandleTypeDef hsdram1;

/* Definitions for hardwareTask */
osThreadId_t hardwareTaskHandle;
const osThreadAttr_t hardwareTask_attributes = {
  .name = "hardwareTask",
  .stack_size = 512 * 4,
  .priority = (osPriority_t) osPriorityNormal,
};
/* Definitions for touchGFXTask */
osThreadId_t touchGFXTaskHandle;
const osThreadAttr_t touchGFXTask_attributes = {
  .name = "touchGFXTask",
  .stack_size = 8192 * 4,
  .priority = (osPriority_t) osPriorityNormal,
};
/* Definitions for lcdDebugTask */
osThreadId_t lcdDebugTaskHandle;
const osThreadAttr_t lcdDebugTask_attributes = {
  .name = "lcdDebugTask",
  .stack_size = 512 * 4,
  .priority = (osPriority_t) osPriorityNormal,
};
/* Definitions for DataQueue */
osMessageQueueId_t DataQueueHandle;
const osMessageQueueAttr_t DataQueue_attributes = {
  .name = "DataQueue"
};
void SystemClock_Config(void);
static void MX_GPIO_Init(void);
static void MX_CRC_Init(void);
static void MX_DMA2D_Init(void);
static void MX_FMC_Init(void);
static void MX_I2C3_Init(void);
static void MX_LTDC_Init(void);
static void MX_SPI5_Init(void);
static void MX_TIM1_Init(void);
static void MX_CAN2_Init(void);
static void MX_RNG_Init(void);
void StartHardwareTask(void *argument);
void StartTGFXTask(void *argument);
void StartLcdDebugTask(void *argument);

/* USER CODE BEGIN PFP */
static void BSP_SDRAM_Initialization_Sequence(SDRAM_HandleTypeDef *hsdram, FMC_SDRAM_CommandTypeDef *Command);

static uint8_t I2C3_ReadData(uint8_t Addr, uint8_t Reg);
static void I2C3_WriteData(uint8_t Addr, uint8_t Reg, uint8_t Value);
static uint8_t I2C3_ReadBuffer(uint8_t Addr, uint8_t Reg, uint8_t *pBuffer, uint16_t Length);

/* IOExpander IO functions */
void IOE_Init(void);
void IOE_ITConfig(void);
void IOE_Delay(uint32_t Delay);
void IOE_Write(uint8_t Addr, uint8_t Reg, uint8_t Value);
uint8_t IOE_Read(uint8_t Addr, uint8_t Reg);
uint16_t IOE_ReadMultiple(uint8_t Addr, uint8_t Reg, uint8_t *pBuffer, uint16_t Length);
/* USER CODE END PFP */

/* USER CODE BEGIN 0 */
uint32_t I2c3Timeout = I2C3_TIMEOUT_MAX; /*<! Value of Timeout when I2C communication fails */

/* USER CODE END 0 */

/**
  * @brief  The application entry point.
  * @retval int
  */
int main(void)
{

  /* MCU Configuration--------------------------------------------------------*/

  /* Reset of all peripherals, Initializes the Flash interface and the Systick. */
  HAL_Init();

  /* Configure the system clock */
  SystemClock_Config();

  /* Initialize all configured peripherals */
  MX_GPIO_Init();
  MX_CRC_Init();
  MX_DMA2D_Init();
  MX_FMC_Init();
  MX_I2C3_Init();
  MX_LTDC_Init();
  MX_SPI5_Init();
  MX_TIM1_Init();
  MX_CAN2_Init();
  MX_RNG_Init();
  MX_TouchGFX_Init();
  /* Call PreOsInit function */
  MX_TouchGFX_PreOSInit();
  /* USER CODE BEGIN 2 */
  MFD_DataInit();

  // DEBUG Controllers Init
  DBGS_init();
  DBGD_init();

  COMM_init();

  // SW RST
  I2C3_WriteData(0x54, 0x17, 0b00000010);

  // SD Mode Register 1
  I2C3_WriteData(0x54, 0x80, 0x10); // 0b00010000
  // SD standard - NTSC
  // SD luma filter - Luma SSAF
  // SD chroma filter - 1.3 MHz

  // SD Mode Register 2 (0x0B 0b00001011)
  I2C3_WriteData(0x54, 0x82, 0b01001011);
  // SD PrPb SSAF filter - Enabled
  // SD DAC Output 1 - 1
  // SD pedestal - Enabled
  // SD square pixel mode - Disabled
  // SD VCR FF/RW sync - Disabled
  // SD pixel data valid - Disabled
  // SD active video edge control - Disabled

  // SD Mode Register 3
  I2C3_WriteData(0x54, 0x83, 0x04); // 0b00000100
  // SD pedestal YPrPb output - No pedestal on YPrPb
  // SD Output Levels Y - Y = 700 mV/300 mV
  // SD Output Levels PrPb - 700 mV p-p
  // SD vertical blanking interval (VBI) open - Disabled
  // SD closed captioning field control - Closed captioning disabled

  // SD Mode Register 4
  I2C3_WriteData(0x54, 0x84, 0x00); // 0b00000000
  // SD SFL/SCR/TR mode select - Disabled
  // SD active video length - 720 pixels
  // SD chroma - Chroma enabled
  // SD burst - Enabled
  // SD color bars - Disabled
  // SD luma/chroma swap - DAC 2 = luma, DAC 3 = chroma

  // SD Mode Register 5 (0x02 0b00000010)
  I2C3_WriteData(0x54, 0x86, 0b00000010);
  // NTSC color subcarrier adjust - 5.59 μs (must be set for Macrovision compliance)
  // SD EIA/CEA-861B synchronization compliance - Disabled
  // SD horizontal/vertical counter mode (1) - Update field/line counter
  // SD RGB color swap - Normal

  /* (1) When set to 0, the horizontal/vertical counters automatically wrap around at the end of the line/field/frame of the selected standard. When set to 1, the
horizontal/vertical counters are free running and wrap around when external sync signals indicate to do so. */

  // SD Mode Register 6
  I2C3_WriteData(0x54, 0x87, 0x80); // 0b10100000 0xA0 (autodetect) // 0b10000000 0x80 (def)
  // SD Mode Register 7
  I2C3_WriteData(0x54, 0x88, 0x12); // 0b00010010 0x12 (non-interlaced) // 0b00010000 0x10 (interlaced)
  // SD Mode Register 8
  I2C3_WriteData(0x54, 0x8A, 0b00001100); // Mode 2 — Slave Option (Subaddress 0x8A = X X X X X 1 0 0)

  // Color bars
//    I2C3_WriteData(0x54, 0x00, 0b00010010);
//    I2C3_WriteData(0x54, 0x82, 0b11001011); // 0b00001011 (reset) // 0b11001011 (bars)
//    I2C3_WriteData(0x54, 0x84, 0b01000000); // 0b00000000 (reset) // 0b01000000 (bars)

  //  I2C3_WriteData(0x54, 0x87, 0x80);
  //  I2C3_WriteData(0x54, 0x88, 0x12);
  //  volatile uint8_t b1r = I2C3_ReadData(0x55, 0x87);
  //  volatile uint8_t b2r = I2C3_ReadData(0x55, 0x88);

  /* USER CODE END 2 */

  /* Init scheduler */
  osKernelInitialize();

  /* USER CODE BEGIN RTOS_MUTEX */
  /* add mutexes, ... */
  /* USER CODE END RTOS_MUTEX */

  /* USER CODE BEGIN RTOS_SEMAPHORES */
  /* add semaphores, ... */
  /* USER CODE END RTOS_SEMAPHORES */

  /* USER CODE BEGIN RTOS_TIMERS */
  /* start timers, add new ones, ... */
  /* USER CODE END RTOS_TIMERS */

  /* Create the queue(s) */
  /* creation of DataQueue */
  DataQueueHandle = osMessageQueueNew (16, sizeof(uint16_t), &DataQueue_attributes);

  /* USER CODE BEGIN RTOS_QUEUES */
  /* add queues, ... */
  /* USER CODE END RTOS_QUEUES */

  /* Create the thread(s) */
  /* creation of hardwareTask */
  hardwareTaskHandle = osThreadNew(StartHardwareTask, NULL, &hardwareTask_attributes);

  /* creation of touchGFXTask */
  touchGFXTaskHandle = osThreadNew(StartTGFXTask, NULL, &touchGFXTask_attributes);

  /* creation of lcdDebugTask */
  lcdDebugTaskHandle = osThreadNew(StartLcdDebugTask, NULL, &lcdDebugTask_attributes);

  /* USER CODE BEGIN RTOS_THREADS */
  /* add threads, ... */
  /* USER CODE END RTOS_THREADS */

  /* USER CODE BEGIN RTOS_EVENTS */
  /* add events, ... */
  /* USER CODE END RTOS_EVENTS */

  /* Start scheduler */
  osKernelStart();

  /* We should never get here as control is now taken by the scheduler */

  /* Infinite loop */
  /* USER CODE BEGIN WHILE */
  while (1)
  {
    /* USER CODE END WHILE */

    /* USER CODE BEGIN 3 */
  }
  /* USER CODE END 3 */
}

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
/* USER CODE BEGIN 4 */

/**
  * @brief  Perform the SDRAM external memory initialization sequence
  * @param  hsdram: SDRAM handle
  * @param  Command: Pointer to SDRAM command structure
  * @retval None
  */
static void BSP_SDRAM_Initialization_Sequence(SDRAM_HandleTypeDef *hsdram, FMC_SDRAM_CommandTypeDef *Command)
{
  __IO uint32_t tmpmrd =0;

  /* Step 1:  Configure a clock configuration enable command */
  Command->CommandMode             = FMC_SDRAM_CMD_CLK_ENABLE;
  Command->CommandTarget           = FMC_SDRAM_CMD_TARGET_BANK2;
  Command->AutoRefreshNumber       = 1;
  Command->ModeRegisterDefinition  = 0;

  /* Send the command */
  HAL_SDRAM_SendCommand(hsdram, Command, SDRAM_TIMEOUT);

  /* Step 2: Insert 100 us minimum delay */
  /* Inserted delay is equal to 1 ms due to systick time base unit (ms) */
  HAL_Delay(1);

  /* Step 3: Configure a PALL (precharge all) command */
  Command->CommandMode             = FMC_SDRAM_CMD_PALL;
  Command->CommandTarget           = FMC_SDRAM_CMD_TARGET_BANK2;
  Command->AutoRefreshNumber       = 1;
  Command->ModeRegisterDefinition  = 0;

  /* Send the command */
  HAL_SDRAM_SendCommand(hsdram, Command, SDRAM_TIMEOUT);

  /* Step 4: Configure an Auto Refresh command */
  Command->CommandMode             = FMC_SDRAM_CMD_AUTOREFRESH_MODE;
  Command->CommandTarget           = FMC_SDRAM_CMD_TARGET_BANK2;
  Command->AutoRefreshNumber       = 4;
  Command->ModeRegisterDefinition  = 0;

  /* Send the command */
  HAL_SDRAM_SendCommand(hsdram, Command, SDRAM_TIMEOUT);

  /* Step 5: Program the external memory mode register */
  tmpmrd = (uint32_t)SDRAM_MODEREG_BURST_LENGTH_1          |
           SDRAM_MODEREG_BURST_TYPE_SEQUENTIAL   |
           SDRAM_MODEREG_CAS_LATENCY_3           |
           SDRAM_MODEREG_OPERATING_MODE_STANDARD |
           SDRAM_MODEREG_WRITEBURST_MODE_SINGLE;

  Command->CommandMode             = FMC_SDRAM_CMD_LOAD_MODE;
  Command->CommandTarget           = FMC_SDRAM_CMD_TARGET_BANK2;
  Command->AutoRefreshNumber       = 1;
  Command->ModeRegisterDefinition  = tmpmrd;

  /* Send the command */
  HAL_SDRAM_SendCommand(hsdram, Command, SDRAM_TIMEOUT);

  /* Step 6: Set the refresh rate counter */
  /* Set the device refresh rate */
  HAL_SDRAM_ProgramRefreshRate(hsdram, REFRESH_COUNT);
}

/**
  * @brief  IOE Low Level Initialization.
  */
void IOE_Init(void)
{
  // Dummy function called when initializing to stmpe811 to setup the i2c.
  // This is done with cubemx and is therfore not done here.
}

/**
  * @brief  IOE Low Level Interrupt configuration.
  */
void IOE_ITConfig(void)
{
  // Dummy function called when initializing to stmpe811 to setup interupt for the i2c.
  // The interupt is not used in our case, therefore nothing is done here.
}

/**
  * @brief  IOE Writes single data operation.
  * @param  Addr: I2C Address
  * @param  Reg: Reg Address
  * @param  Value: Data to be written
  */
void IOE_Write(uint8_t Addr, uint8_t Reg, uint8_t Value)
{
  I2C3_WriteData(Addr, Reg, Value);
}

/**
  * @brief  IOE Reads single data.
  * @param  Addr: I2C Address
  * @param  Reg: Reg Address
  * @retval The read data
  */
uint8_t IOE_Read(uint8_t Addr, uint8_t Reg)
{
  return I2C3_ReadData(Addr, Reg);
}

/**
  * @brief  IOE Reads multiple data.
  * @param  Addr: I2C Address
  * @param  Reg: Reg Address
  * @param  pBuffer: pointer to data buffer
  * @param  Length: length of the data
  * @retval 0 if no problems to read multiple data
  */
uint16_t IOE_ReadMultiple(uint8_t Addr, uint8_t Reg, uint8_t *pBuffer, uint16_t Length)
{
  return I2C3_ReadBuffer(Addr, Reg, pBuffer, Length);
}

/**
  * @brief  IOE Delay.
  * @param  Delay in ms
  */
void IOE_Delay(uint32_t Delay)
{
  HAL_Delay(Delay);
}

/**
  * @brief  Writes a value in a register of the device through BUS.
  * @param  Addr: Device address on BUS Bus.
  * @param  Reg: The target register address to write
  * @param  Value: The target register value to be written
  */
static void I2C3_WriteData(uint8_t Addr, uint8_t Reg, uint8_t Value)
{
  HAL_StatusTypeDef status = HAL_OK;

  status = HAL_I2C_Mem_Write(&hi2c3, Addr, (uint16_t)Reg, I2C_MEMADD_SIZE_8BIT, &Value, 1, I2c3Timeout);

  /* Check the communication status */
  if(status != HAL_OK)
  {
    /* Re-Initialize the BUS */
    //I2Cx_Error();
  }
}

/**
  * @brief  Reads a register of the device through BUS.
  * @param  Addr: Device address on BUS Bus.
  * @param  Reg: The target register address to write
  * @retval Data read at register address
  */
static uint8_t I2C3_ReadData(uint8_t Addr, uint8_t Reg)
{
  HAL_StatusTypeDef status = HAL_OK;
  uint8_t value = 0;

  status = HAL_I2C_Mem_Read(&hi2c3, Addr, Reg, I2C_MEMADD_SIZE_8BIT, &value, 1, I2c3Timeout);

  /* Check the communication status */
  if(status != HAL_OK)
  {
    /* Re-Initialize the BUS */
    //I2Cx_Error();

  }
  return value;
}

/**
  * @brief  Reads multiple data on the BUS.
  * @param  Addr: I2C Address
  * @param  Reg: Reg Address
  * @param  pBuffer: pointer to read data buffer
  * @param  Length: length of the data
  * @retval 0 if no problems to read multiple data
  */
static uint8_t I2C3_ReadBuffer(uint8_t Addr, uint8_t Reg, uint8_t *pBuffer, uint16_t Length)
{
  HAL_StatusTypeDef status = HAL_OK;

  status = HAL_I2C_Mem_Read(&hi2c3, Addr, (uint16_t)Reg, I2C_MEMADD_SIZE_8BIT, pBuffer, Length, I2c3Timeout);

  /* Check the communication status */
  if(status == HAL_OK)
  {
    return 0;
  }
  else
  {
    /* Re-Initialize the BUS */
    //I2Cx_Error();

    return 1;
  }
}
/* USER CODE END 4 */

/* USER CODE BEGIN Header_StartHardwareTask */
/**
  * @brief  Function implementing the hardwareTask thread.
  * @param  argument: Not used
  * @retval None
  */
/* USER CODE END Header_StartHardwareTask */
void StartHardwareTask(void *argument)
{
  /* USER CODE BEGIN 5 */
  /* Infinite loop */
  for(;;)
  {
    DBGD_tick();
  }
  /* USER CODE END 5 */
}

/* USER CODE BEGIN Header_StartTGFXTask */
/**
* @brief Function implementing the touchGFXTask thread.
* @param argument: Not used
* @retval None
*/
/* USER CODE END Header_StartTGFXTask */
void StartTGFXTask(void *argument)
{
  /* USER CODE BEGIN StartTGFXTask */
  MX_TouchGFX_Process();
  /* Infinite loop */
  for(;;)
  {
    osDelay(1);
  }
  /* USER CODE END StartTGFXTask */
}

/* USER CODE BEGIN Header_StartLcdDebugTask */
/**
* @brief Function implementing the lcdDebugTask thread.
* @param argument: Not used
* @retval None
*/
/* USER CODE END Header_StartLcdDebugTask */
void StartLcdDebugTask(void *argument)
{
  /* USER CODE BEGIN StartLcdDebugTask */
  /* Infinite loop */
  for(;;)
  {
    DBGS_tick();
  }
  /* USER CODE END StartLcdDebugTask */
}

/**
  * @brief  Period elapsed callback in non blocking mode
  * @note   This function is called  when TIM6 interrupt took place, inside
  * HAL_TIM_IRQHandler(). It makes a direct call to HAL_IncTick() to increment
  * a global variable "uwTick" used as application time base.
  * @param  htim : TIM handle
  * @retval None
  */
void HAL_TIM_PeriodElapsedCallback(TIM_HandleTypeDef *htim)
{
  if (htim->Instance == TIM6) {
    HAL_IncTick();
  }
}

/**
  * @brief  This function is executed in case of error occurrence.
  * @retval None
  */
void Error_Handler(void)
{
  /* USER CODE BEGIN Error_Handler_Debug */
  /* User can add his own implementation to report the HAL error return state */
  __disable_irq();
  while (1)
  {
  }
  /* USER CODE END Error_Handler_Debug */
}

#ifdef  USE_FULL_ASSERT
/**
  * @brief  Reports the name of the source file and the source line number
  *         where the assert_param error has occurred.
  * @param  file: pointer to the source file name
  * @param  line: assert_param error line source number
  * @retval None
  */
void assert_failed(uint8_t *file, uint32_t line)
{
  /* USER CODE BEGIN 6 */
  /* User can add his own implementation to report the file name and line number,
     ex: printf("Wrong parameters value: file %s on line %d\r\n", file, line) */
  /* USER CODE END 6 */
}
#endif /* USE_FULL_ASSERT */
