irudoy/openmfd/(commit log)

2022-06-03 set up can bus
2022-06-22 fix cbus mnr, fix minmax clt
    [comm.c, comm.h, data.c]
2022-06-25 switch peak/current
2022-06-25 current pos mnr
2022-10-31 fix HW btn controller
    [comm.c]
2024-05-24 add old schematics
    [openmfd.kicad_pcb, openmfd.kicad_sch, rgb-composite-ntsc-pal-bak.kicad_sch, rgb-composite.kicad_pcb, rgb-composite.kicad_sch, rgb_dac.kicad_sch]
2024-07-10 adv7393 dev-board wip
    [dac_1.kicad_sch, dac_2.kicad_sch, dev-board.kicad_pcb, dev-board.kicad_sch]
2024-07-15 adv7393 dev-board done
    [dac_1.kicad_sch, dev-board.kicad_pcb]
2025-02-26 fix devboard sch
    [dev-board.kicad_sch]
