irudoy/openmfd/(notices)

Notices in the files:
firmware/Core/Inc/main.h:
Copyright (c) 2022 STMicroelectronics.
All rights reserved.
This software is licensed under terms that can be found in the LICENSE file
parts and their libraries:
Copyright 2021 Accelerated Designs. All rights reserved.
